PlasmonicXenon/rgh_coolrunner_64/rgh_coolrunner_64.pdf

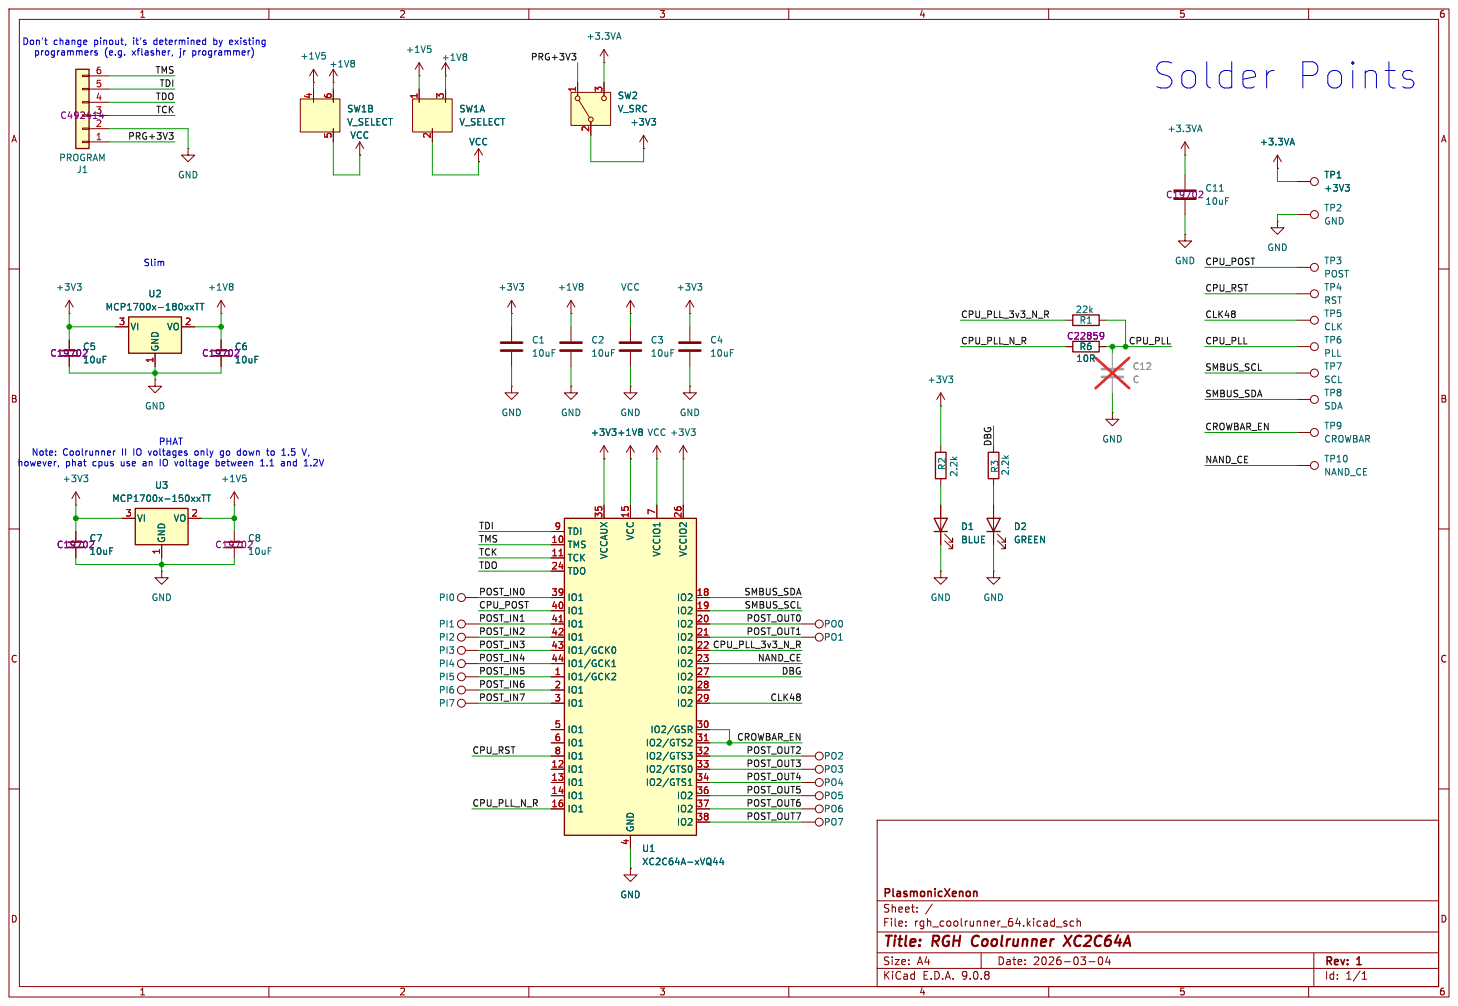
[picture p1: page 1]

Id: 1/1 Title: RGH Coolrunner XC2C64A
