PlasmonicXenon/rgh_coolrunner_64/rgh_coolrunner_64.kicad_pcb

## KiCad design rgh_coolrunner_64.kicad_pcb (2026-04-25)

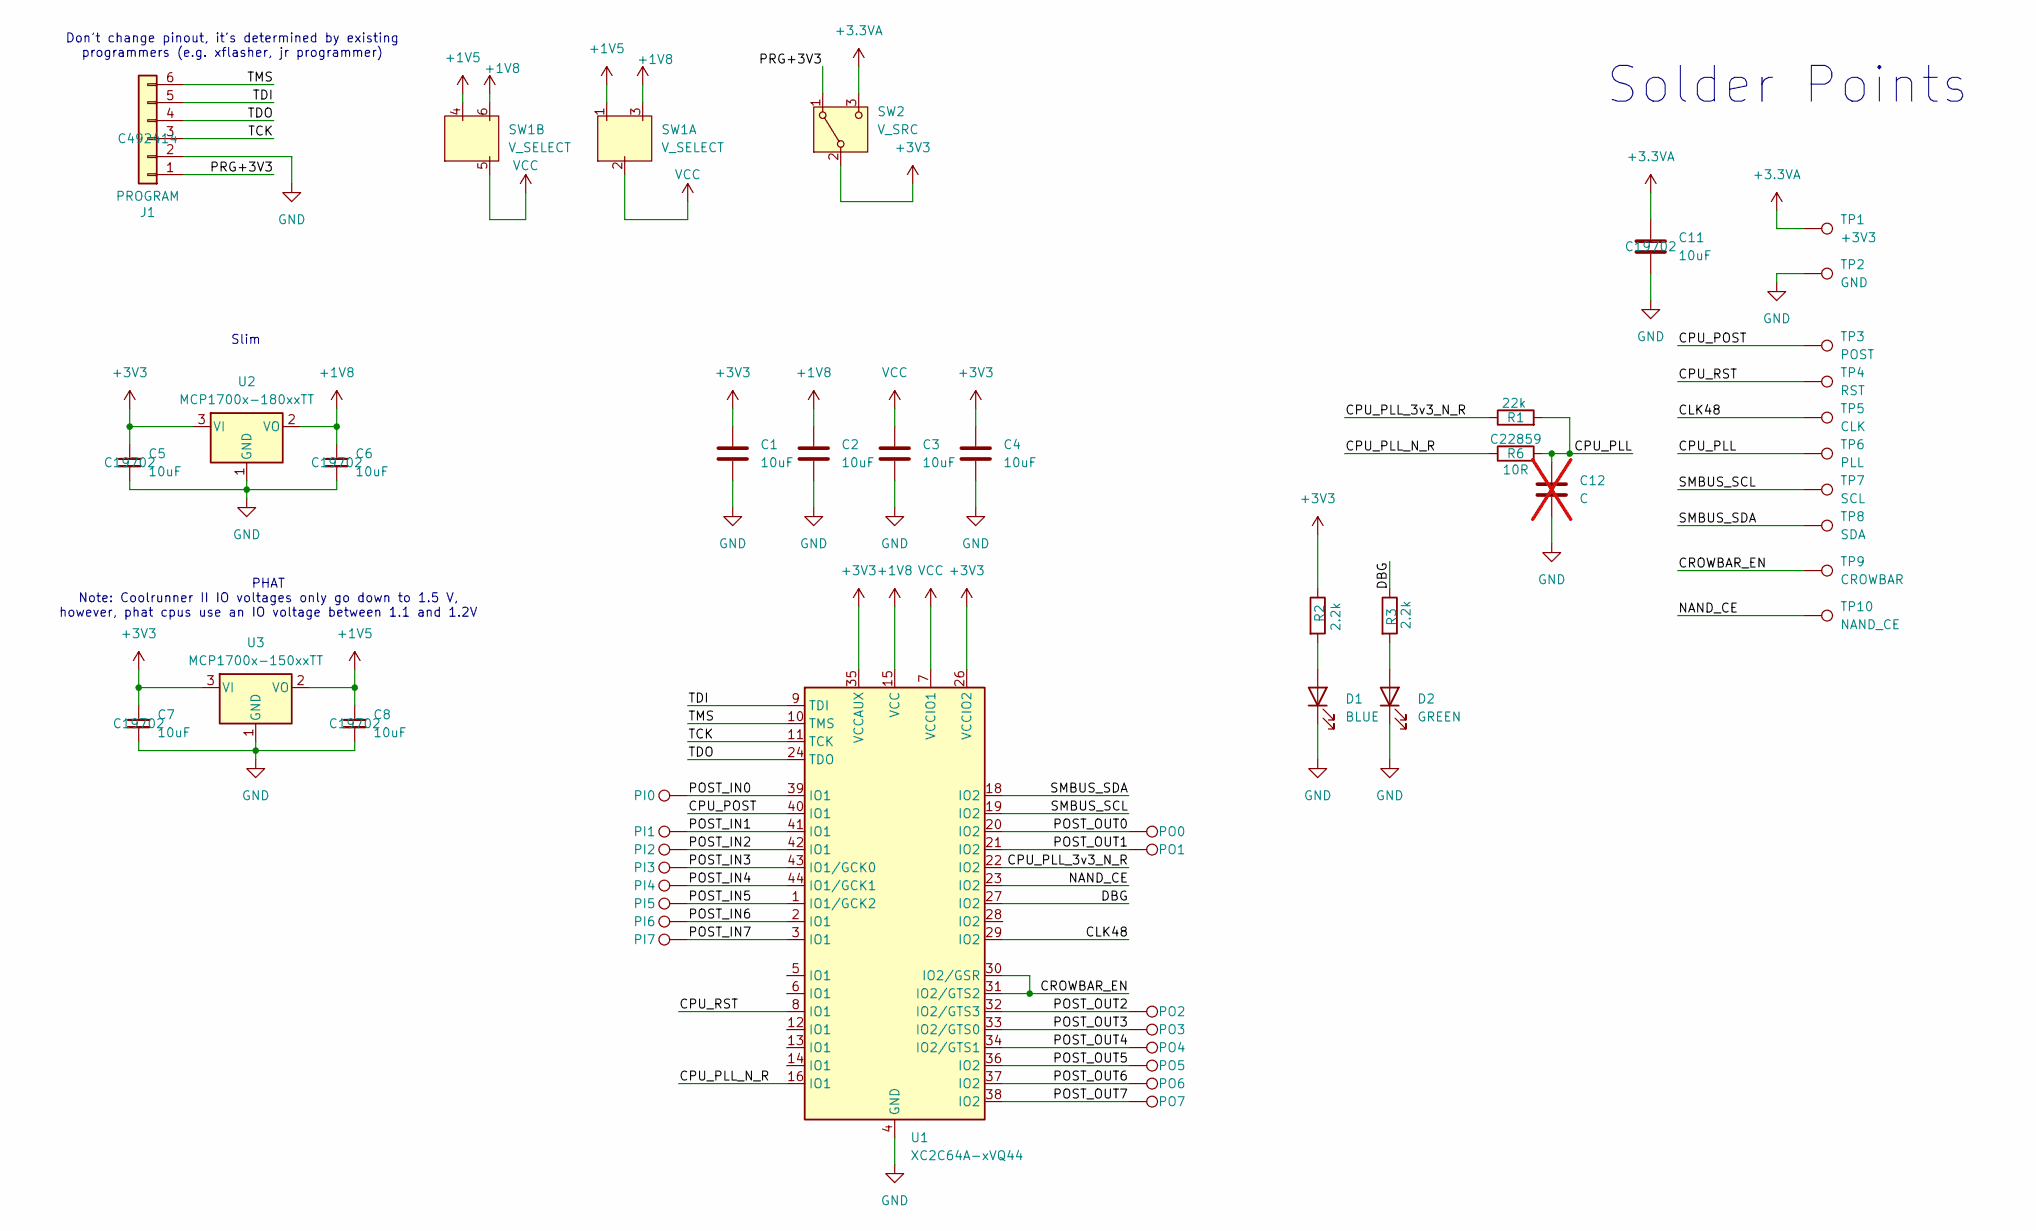
[picture p2: schematic rgh_coolrunner_64.kicad_sch, RGH Coolrunner XC2C64A]

Parts:
C1, C2, C3, C4: 10uF; C_0603_1608Metric
C5, C6, C7, C8, C11: 10uF; C_0603_1608Metric; LCSC Part # C19702
C12: C; C_0805_2012Metric_Pad1.18x1.45mm_HandSolder; not fitted
D1: BLUE; LED_0603_1608Metric; LCSC Part # C965807
D2: GREEN; LED_0603_1608Metric
J1: PROGRAM; PinHeader_1x06_P2.54mm_Horizontal; LCSC Part # C492414
PI0, PI1, PI2, PI3, PI4, PI5, PI6, PI7: TestPoint; TestPoint_Pad_D1.0mm
PO0, PO1, PO2, PO3, PO4, PO5, PO6, PO7: TestPoint; TestPoint_Pad_D1.0mm
R1: 22k; R_0603_1608Metric_Pad0.98x0.95mm_HandSolder
R2, R3: 2.2k; R_0603_1608Metric
R6: 10R; R_0603_1608Metric_Pad0.98x0.95mm_HandSolder; LCSC Part # C22859
SW1: V_SELECT; SW_DPDT_CK_JS202011JCQN
SW2: V_SRC; SW_SPDT_PCM12
TP1: +3V3; TestPoint_Pad_D2.0mm
TP2: GND; TestPoint_Pad_D2.0mm
TP3: POST; TestPoint_Pad_D2.0mm
TP4: RST; TestPoint_Pad_D2.0mm
TP5: CLK; TestPoint_Pad_D2.0mm
TP6: PLL; TestPoint_Pad_D2.0mm
TP7: SCL; TestPoint_Pad_D2.0mm
TP8: SDA; TestPoint_Pad_D2.0mm
TP9: CROWBAR; TestPoint_Pad_D2.0mm
TP10: NAND_CE; TestPoint_Pad_D2.0mm
U1: XC2C64A-xVQ44; TQFP-44_10x10mm_P0.8mm
U2: MCP1700x-180xxTT; SOT-23
U3: MCP1700x-150xxTT; SOT-23

Connections:
+1V5: C8.1, SW1.1 (A), SW1.4, U3.2 (VO)
+1V8: C2.1, C6.1, SW1.3 (C), SW1.6, U1.15 (VCC), U2.2 (VO)
+3.3VA: C11.1, SW2.3 (C), TP1.1
+3V3: C1.1, C4.1, C5.1, C7.1, R2.1, SW2.2 (B), U1.26 (VCCIO2), U1.35 (VCCAUX), U2.3 (VI), U3.3 (VI)
/CLK48: TP5.1, U1.29 (IO2)
/CPU_PLL: C12.1, R1.2, R6.2, TP6.1
/CPU_PLL_3v3_N_R: R1.1, U1.22 (IO2)
/CPU_PLL_N_R: R6.1, U1.16 (IO1)
/CPU_POST: TP3.1, U1.40 (IO1)
/CPU_RST: TP4.1, U1.8 (IO1)
/CROWBAR_EN: TP9.1, U1.30 (IO2/GSR), U1.31 (IO2/GTS2)
/DBG: R3.1, U1.27 (IO2)
/NAND_CE: TP10.1, U1.23 (IO2)
/POST_IN0: PI0.1, U1.39 (IO1)
/POST_IN1: PI1.1, U1.41 (IO1)
/POST_IN2: PI2.1, U1.42 (IO1)
/POST_IN3: PI3.1, U1.43 (IO1/GCK0)
/POST_IN4: PI4.1, U1.44 (IO1/GCK1)
/POST_IN5: PI5.1, U1.1 (IO1/GCK2)
/POST_IN6: PI6.1, U1.2 (IO1)
/POST_IN7: PI7.1, U1.3 (IO1)
/POST_OUT0: PO0.1, U1.20 (IO2)
/POST_OUT1: PO1.1, U1.21 (IO2)
/POST_OUT2: PO2.1, U1.32 (IO2/GTS3)
/POST_OUT3: PO3.1, U1.33 (IO2/GTS0)
/POST_OUT4: PO4.1, U1.34 (IO2/GTS1)
/POST_OUT5: PO5.1, U1.36 (IO2)
/POST_OUT6: PO6.1, U1.37 (IO2)
/POST_OUT7: PO7.1, U1.38 (IO2)
/PRG+3V3: J1.1, SW2.1 (A)
/SMBUS_SCL: TP7.1, U1.19 (IO2)
/SMBUS_SDA: TP8.1, U1.18 (IO2)
/TCK: J1.3, U1.11 (TCK)
/TDI: J1.5, U1.9 (TDI)
/TDO: J1.4, U1.24 (TDO)
/TMS: J1.6, U1.10 (TMS)
GND: C1.2, C2.2, C3.2, C4.2, C5.2, C6.2, C7.2, C8.2, C11.2, C12.2, D1.1 (K), D2.1 (K), J1.2, TP2.1, U1.4 (GND), U1.17 (GND), U1.25 (GND), U2.1 (GND), U3.1 (GND)
unnamed: D1.2 (A), R2.2
unnamed: D2.2 (A), R3.2
VCC: C3.1, SW1.2 (B), SW1.5, U1.7 (VCCIO1)

Notes on the sheet:
Slim
PHAT Note: Coolrunner II IO voltages only go down to 1.5 V, however, phat cpus use an IO voltage between 1.1 and 1.2V
Solder Points
Don't change pinout, it's determined by existing programmers (e.g. xflasher, jr programmer)

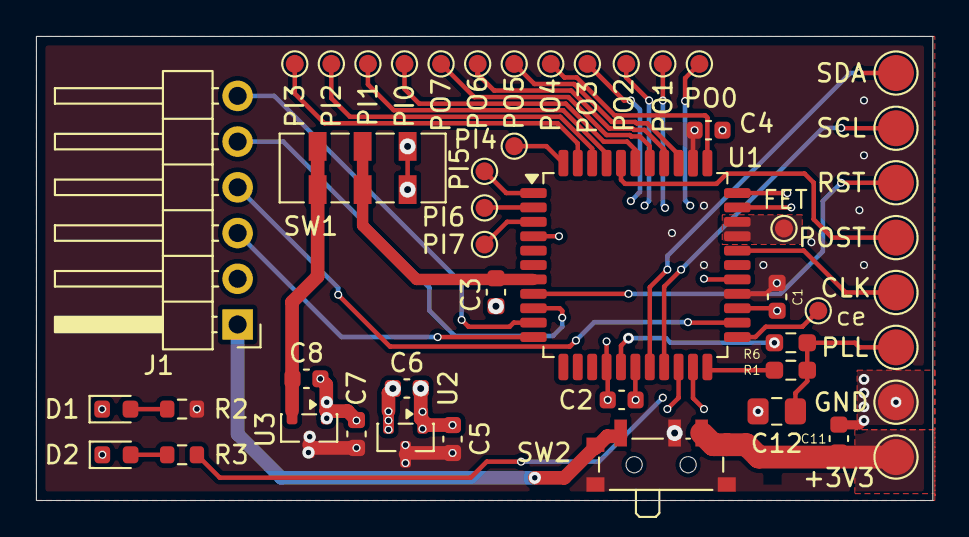
[picture p3: board rgh_coolrunner_64.kicad_pcb from above]

Board: 4 copper layers, 49.8 x 25.8 mm, 48 parts (0 on the bottom side), 40 nets.
